nb4787/analogevse-v2/README.md

# analogevse-v2
AnalogEVSE Version 2

A fully analog J1772 compliant EV charge controller. For details go to the home page

http://www.analogevse.xyz
