nb4787/analogevse-v2/BOM.ods

AnalogEVSE v2.0.0
Component | Value | Count
U1 | 78L12 | 1
U2 | 79L12 | 1
U3,U5 | LM2901 | 2
U4 | CD4060B | 1
 | IC socket 14 pin DIP | 2
 | IC socket 16 pin DIP | 1
Q1,Q3 | BC337 | 2
Q2 | BC557 | 1
D1,D2,D3,D6,D10,D12 | 1N4148 | 6
D4 | Zener 2.4V | 1
D5 | Zener 7.5V | 1
D7 | LED Blue 3mm | 1
D8 | LED Green 3mm | 1
D9 | LED Red 3mm | 1
D11 | LED Yellow 3mm | 1
C1,C4 | 330uF/35V | 2
C6 | 47uF/16V | 1
C3 | 1uF/16V | 1
C7 | 220nF/16V | 1
C2,C5,C8,C11,C12,C13 | 100nF/16V | 6
C9,C10 | 22pF/16V | 2
R8,R14,R19 | 1M | 3
R13 | 56k | 1
R4,R6,R10,R11,R15,R16,R18 | 10k | 7
R3 | 5k6 | 1
R2,R5 | 4k7 | 2
R9,R17 | 3k3 | 2
R1,R7 | 2k2 | 2
R12 | 1k | 1
F1 | Fuse 100mA | 1
 | Fuse holder | 1
K1 | Relay 12V | 1
P1,P3,P4,P6,P7 | Terminal 2-pin | 5
P2,P5 | Terminal 3-pin | 2
Y1 | Quartz 4.096MHz | 1
RV1 | Trimpot 47k (optional) | 1
T1 | Transformer 12V/2VA | 1
 | DIN Rail Enclosure | 1
