nb4787/analogevse-v2/(list of files, drawings)

Other design files:
AnalogEVSE.dsn
