nb4787/analogevse-v2/AnalogEVSE.kicad_pcb

## KiCad design AnalogEVSE.kicad_pcb (2021-08-08)

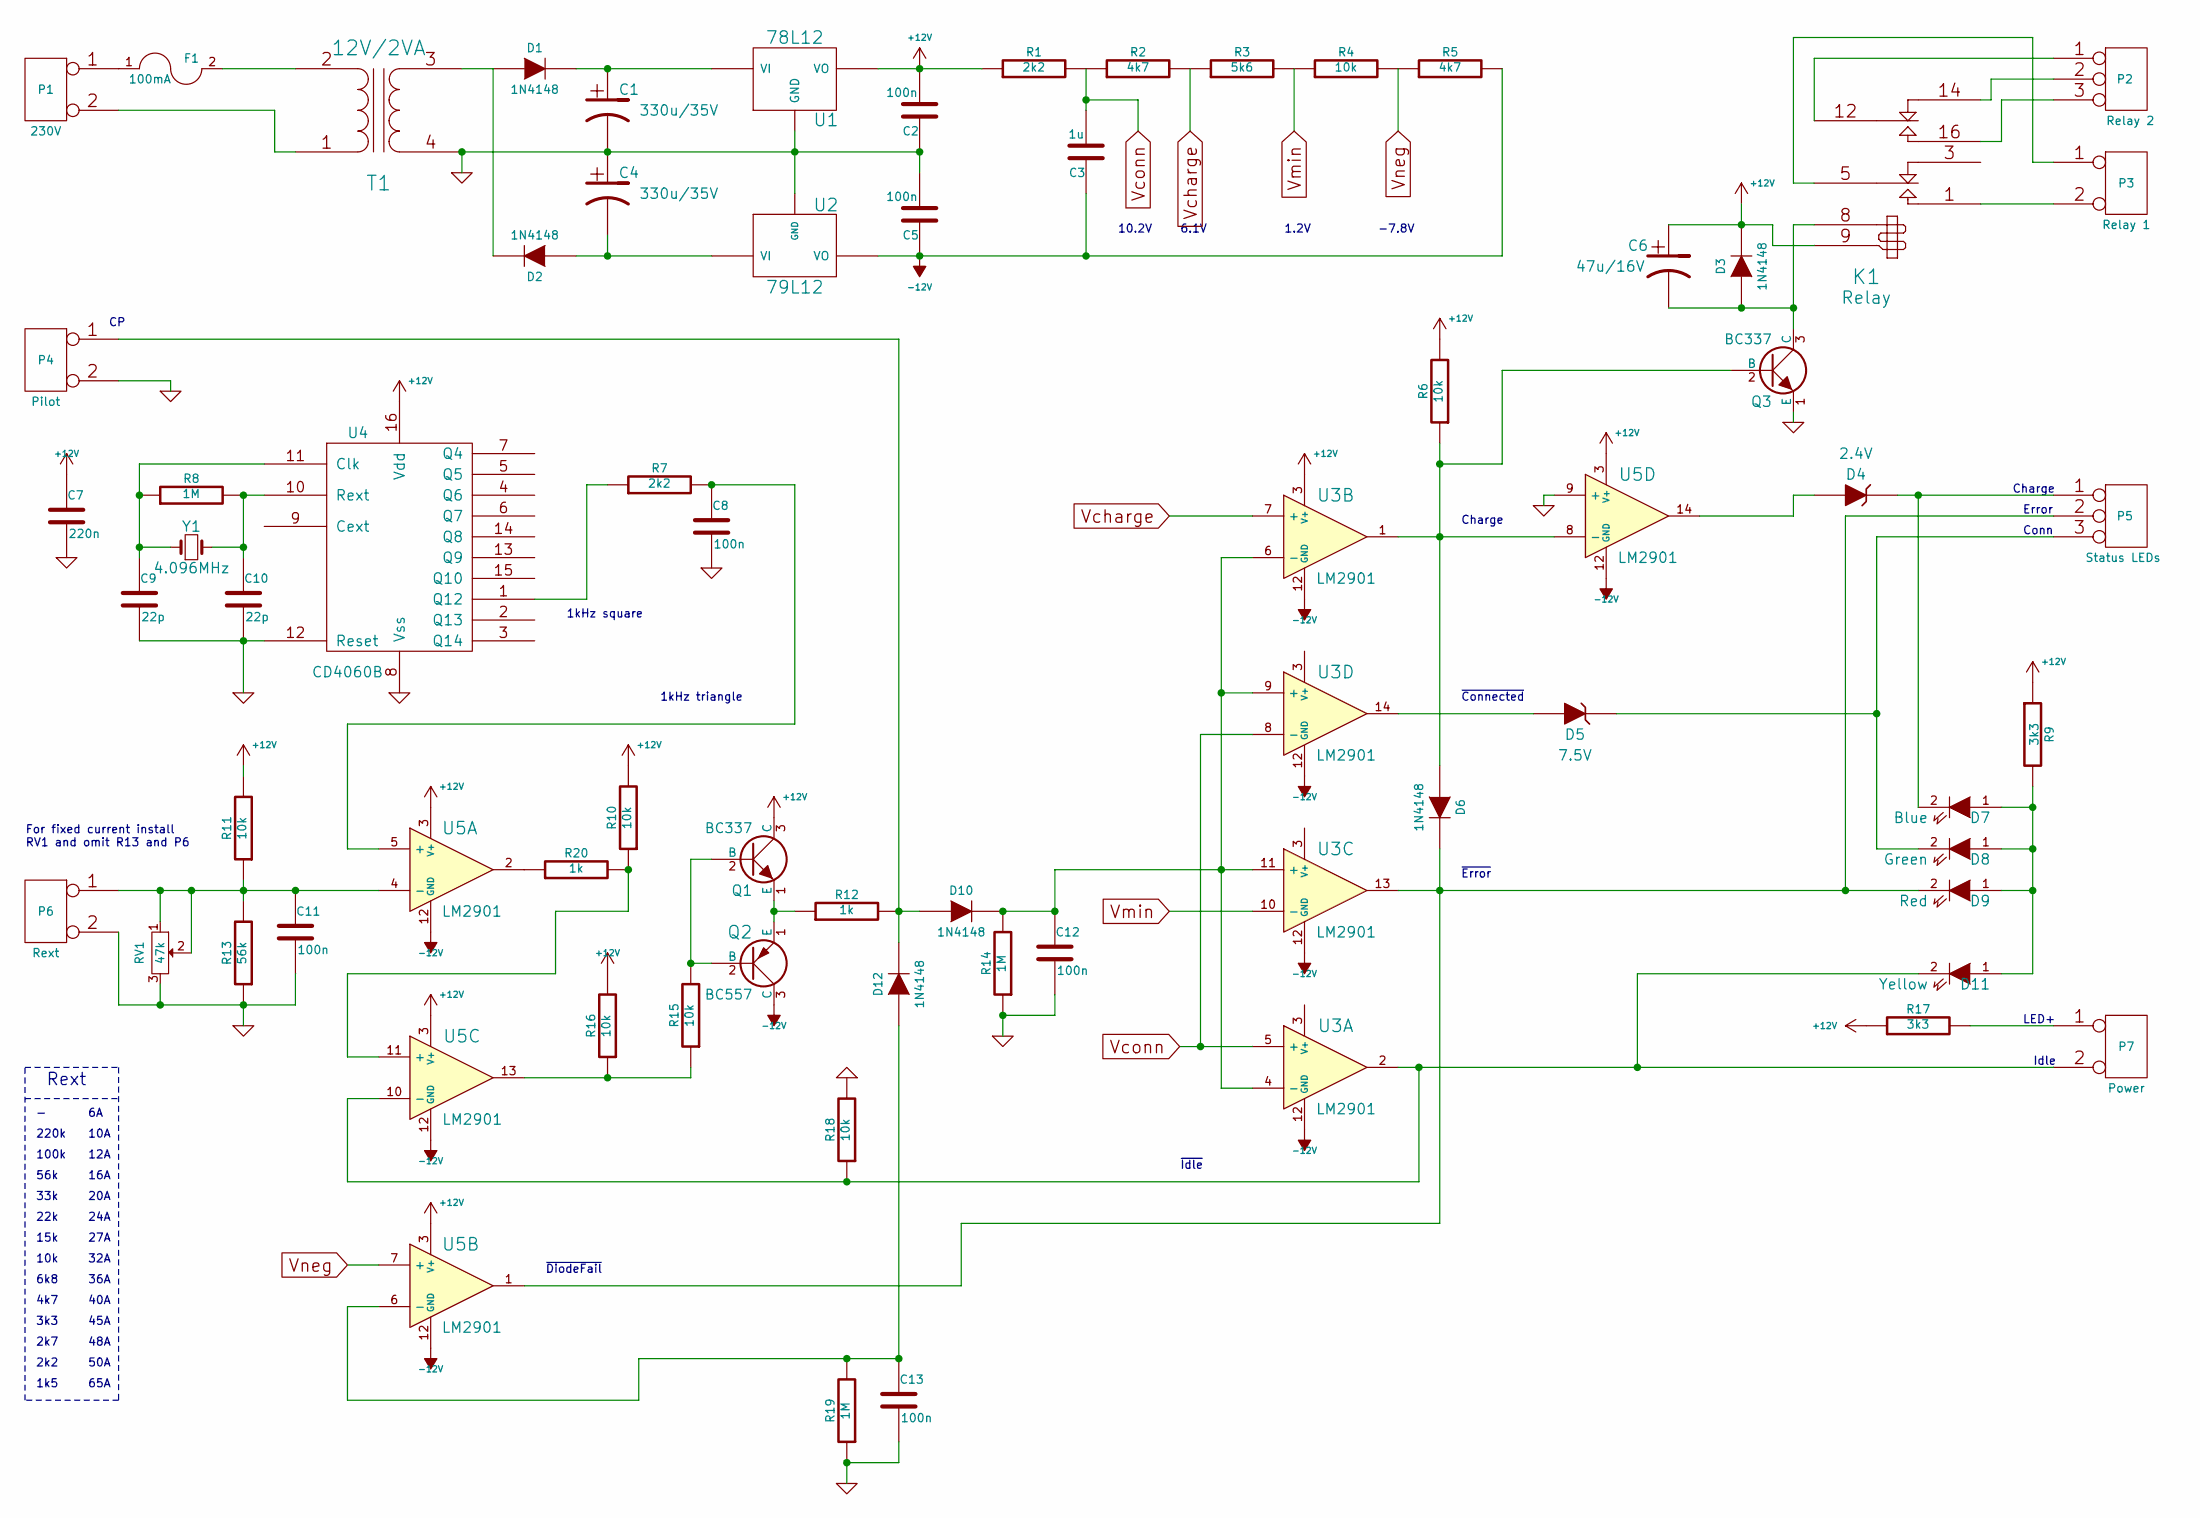
[picture p1: schematic AnalogEVSE.sch]

Parts:
C1, C4: 330u/35V; C5
C2, C5, C8, C11, C12, C13: 100n; C2
C3: 1u; C2
C6: 47u/16V; C3-ROUND
C7: 220n; C2
C9, C10: 22p; C2
D1, D2, D3, D6, D10, D12: 1N4148; D3
D4: 2.4V; D3-Zener
D5: 7.5V; D3-Zener
D7: Blue; LED-3
D8: Green; LED-3
D9: Red; LED-3
D11: Yellow; LED-3
F1: 100mA; Fuse-RM9
K1: Relay
P1: 230V; Term-2pin
P2: Relay 2; Term-3pin
P3: Relay 1; Term-2pin
P4: Pilot; Term-2pin
P5: Status LEDs; Term-3pin
P6: Rext; Term-2pin
P7: Power; Term-2pin
Q1, Q3: BC337; TO92
Q2: BC557; TO92
R1, R7: 2k2; R3.5
R2, R5: 4k7; R3.5
R3: 5k6; R3.5
R4, R6, R10, R11, R15, R16, R18: 10k; R3.5
R8, R14, R19: 1M; R3.5
R9, R17: 3k3; R3.5
R12, R20: 1k; R3.5
R13: 56k; R3.5
RV1: 47k; Trimpot3
T1: 12V/2VA; Printtrafo2VA-multi
U1: 78L12
U2: 79L12
U3, U5: LM2901; IC-DIP-14-SHORT
U4: CD4060B; IC-DIP-16
Y1: 4.096MHz; Crystal

Connections:
+12V: C2.2, C6.1, C7.1, D3.2 (K), K1.9, Q1.3 (C), R1.1, R6.2, R9.1, R10.2, R11.2, R16.2, R17.1, U1.VO, U3.3 (V+), U4.16 (Vdd), U5.3 (V+)
-12V: C3.1, C5.1, Q2.3 (C), R5.2, U2.VO, U3.12 (GND), U5.12 (GND)
GND: C1.2, C2.1, C4.1, C5.2, C7.2, C8.2, C9.2, C10.2, C11.2, C12.2, C13.2, P4.2 (PM), P6.2 (PM), Q3.1 (E), R13.1, R14.1, R18.2, R19.1, RV1.3, T1.4 (SB), U1.GND, U2.GND, U4.8 (Vss), U4.12 (Reset), U5.9 (+)
unnamed: C1.1, D1.2 (K), U1.VI
unnamed: C4.2, D2.1 (A), U2.VI
unnamed: C6.2, D3.1 (A), K1.8, Q3.3 (C)
unnamed: C8.1, R7.2, U5.5 (+)
unnamed: C9.1, R8.1, U4.11 (Clk), Y1.1
unnamed: C10.1, R8.2, U4.10 (Rext), Y1.2
unnamed: C11.1, P6.1, R11.1, R13.2, RV1.1, RV1.2, U5.4 (-)
unnamed: C12.1, D10.2 (K), R14.2, U3.4 (-), U3.6 (-), U3.9 (+), U3.11 (+)
unnamed: C13.1, D12.1 (A), R19.2, U5.6 (-)
unnamed: D1.1 (A), D2.2 (K), T1.3 (SA)
unnamed: D4.1 (K), D7.2 (K), P5.1
unnamed: D4.2 (A), U5.14
unnamed: D5.1 (K), D8.2 (K), P5.3
unnamed: D5.2 (A), U3.14
unnamed: D6.1 (A), Q3.2 (B), R6.1, U3.1, U5.8 (-)
unnamed: D6.2 (K), D9.2 (K), P5.2 (PM), U3.13, U5.1
unnamed: D10.1 (A), D12.2 (K), P4.1, R12.2
unnamed: D7.1 (A), D8.1 (A), D9.1 (A), D11.1 (A), R9.2
unnamed: D11.2 (K), P7.2 (PM), R18.1, U3.2, U5.10 (-)
unnamed: F1.1, P1.1
unnamed: F1.2, T1.2 (AB)
unnamed: K1.1 (T1), P3.2 (PM)
unnamed: K1.5 (C1), P3.1
unnamed: K1.12 (C2), P2.1
unnamed: K1.14 (R2), P2.2 (PM)
unnamed: K1.16 (T2), P2.3
unnamed: P1.2 (PM), T1.1 (AA)
unnamed: P7.1, R17.2
unnamed: Q1.1 (E), Q2.1 (E), R12.1
unnamed: Q1.2 (B), Q2.2 (B), R15.2
unnamed: R7.1, U4.1 (Q12)
unnamed: R10.1, R20.2, U5.11 (+)
unnamed: R15.1, R16.1, U5.13
unnamed: R20.1, U5.2
Vcharge: R2.2, R3.1, U3.7 (+)
Vconn: C3.2, R1.2, R2.1, U3.5 (+), U3.8 (-)
Vmin: R3.2, R4.1, U3.10 (-)
Vneg: R4.2, R5.1, U5.7 (+)

Notes on the sheet:
~DiodeFail
Charge
~Connected
~Error
~Idle
Conn
Error
1kHz square
1kHz triangle
Idle
LED+
220k
10A
100k
12A
56k
16A
10k
32A
33k
20A
22k
24A
15k
27A
2k7
48A
6k8
36A
4k7
40A
3k3
45A
1k5
65A
2k2
50A
Rext
For fixed current install RV1 and omit R13 and P6
10.2V
6.1V
1.2V
-7.8V

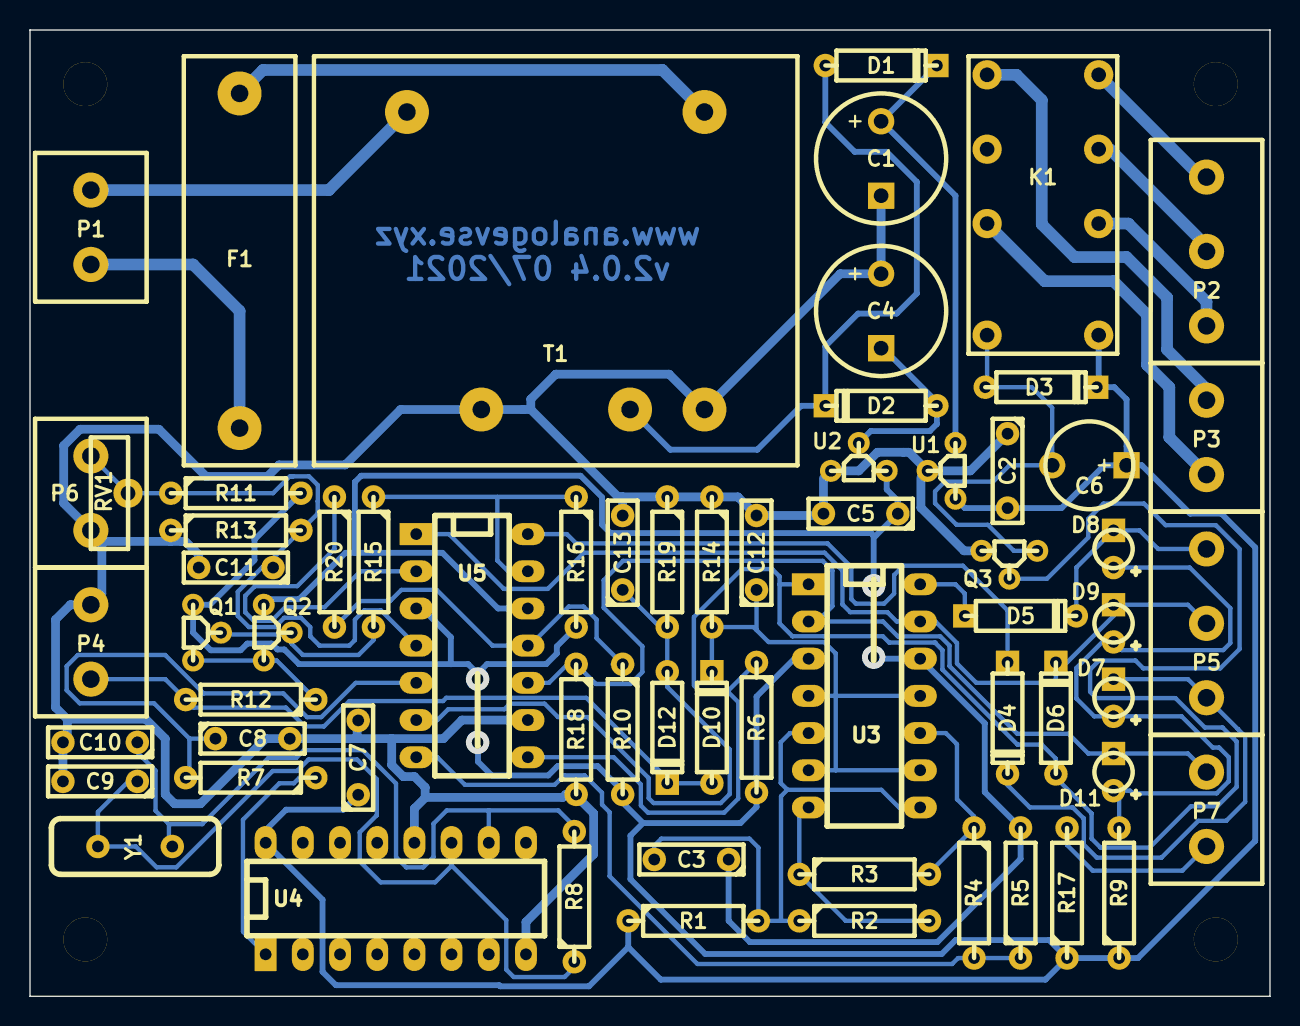
[picture p2: board AnalogEVSE.kicad_pcb from above]

Board: 2 copper layers, 84.7 x 66.0 mm, 65 parts (0 on the bottom side), 41 nets.
