nb4787/analogevse-v2/(commit log)

2018-12-30 Gerber files for PCB manufacturing
    [AnalogEVSE-B.Cu.gbl, AnalogEVSE-B.Mask.gbs, AnalogEVSE-Edge.Cuts.gm1, AnalogEVSE-F.SilkS.gto, AnalogEVSE.drl]
2019-01-03 KiCAD 5, BOM
    [AnalogEVSE.kicad_pcb, AnalogEVSE.sch, BOM.csv, BOM.ods]
2019-01-03 PCB order
    [AnalogEVSE.kicad_pcb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]
2019-05-04 BOM update
    [AnalogEVSE.sch, BOM.ods]
2020-04-18 Release 2.0.3
    [AnalogEVSE.kicad_pcb, AnalogEVSE.sch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]
2021-08-08 Version 2.0.4 with R20 for proper +12V when idle
    [AnalogEVSE.kicad_pcb, AnalogEVSE.sch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]
